Kyuhyeon34/Curvature_Measurement_System/firmware/bd-stm.ioc

Mcu.UserName=STM32F411CEUx
PA0-WKUP.Signal=ADCx_IN0
PA10.Signal=USART1_RX
PA8.Signal=S_TIM1_CH1
PA9.Signal=USART1_TX
