Kyuhyeon34/Curvature_Measurement_System/(commit log)

2026-10-26 레이저 변위센서 곡률 측정 시스템 (2025 산학 프로젝트)
    - STM32F411 펌웨어: UART 명령 기반 원호 연속 스캔, 8x 오버샘플링, Bow/곡률 연산
    - Python GUI: 단면 형상/실시간 거리 그래프, 이동평균 잔차 기반 NG 판정
    - 발표자료, 포스터, README
2026-10-26 docs: README 제목 정리
2026-10-26 docs: 폴더 구조 이름 수정
2026-11-10 docs: 팀 역할 수정 (펌웨어·측정 알고리즘 담당)
2026-11-10 docs: README 요약·분해능 계산 근거·측정 정의 추가, 발표자료 PDF 추가
    - 상단에 수상 · 기간 · 담당 · 결과 요약 표 추가
    - ADC 분해능 13.43μm → 4.75μm 계산 과정 표로 정리 (4.75μm는 이론값)
    - 반복 정밀도 정의, Bow 부호 의미 추가
    - 배운 점을 코드에 있는 진동 · 노이즈 대응으로 구체화
    - 발표자료 · 포스터 PDF 추가 (브라우저에서 바로 보기)
2026-11-10 docs: 발표자료의 시연 영상 2개와 미리보기 추가
2026-11-10 docs: 시연 영상 칸 정리 (README 안에서 바로 재생)
2026-11-10 docs: 시연 영상 순서 수정 및 좌우 배치
2026-11-10 docs: 발표자료 글꼴 깨짐 수정, 반복 정밀도 측정표 추가
    - 아이패드에서 만든 pptx의 한글 글꼴(Arial 지정)이 윈도우에서 명조로 대체되던 문제를 맑은 고딕으로 수정
    - 줄바꿈 · 겹침 5곳 정리 후 PDF 다시 생성
    - 포스터의 샘플별 반복 정밀도(표준편차) 표를 README에 추가
